sciencemakersSE/Turbiditetsmatare/koppling_bb.jpg

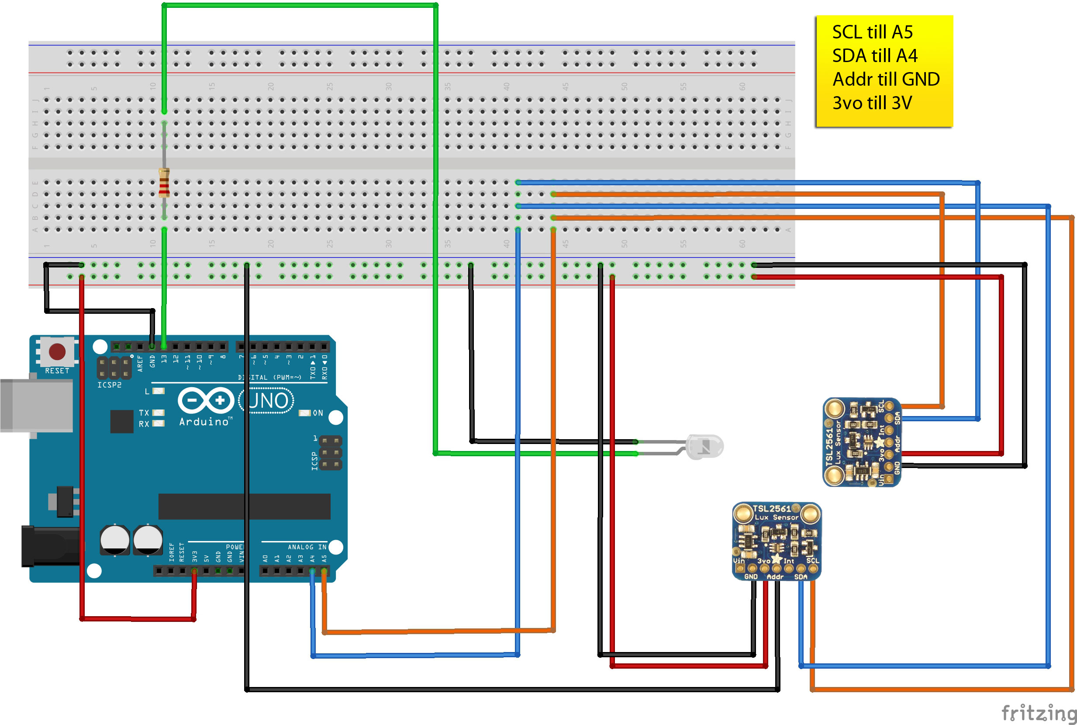
koppling_bb.jpg
