sciencemakersSE/Turbiditetsmatare/Turbidity_sensor_with_LCD.jpg

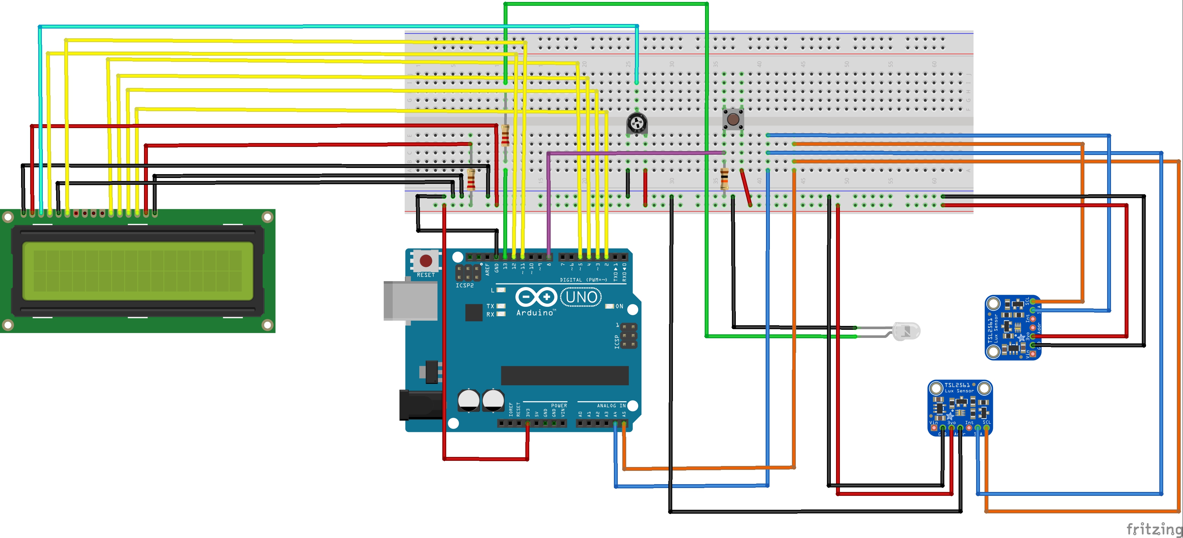
Turbidity_sensor_with_LCD.jpg
