sciencemakersSE/Turbiditetsmatare/README.md

# Turbiditetsmätare/ Turbidity meter
Här hittar man bygginstruktioner, kopplingsschema och Arduinokod till en turbiditetsmätare byggd i Lego.

Here are build instructions, wiring diagrams and Arduino code to a turbidity meter built in Lego
