sciencemakersSE/Turbiditetsmatare/Page_9_med_elektronik.png

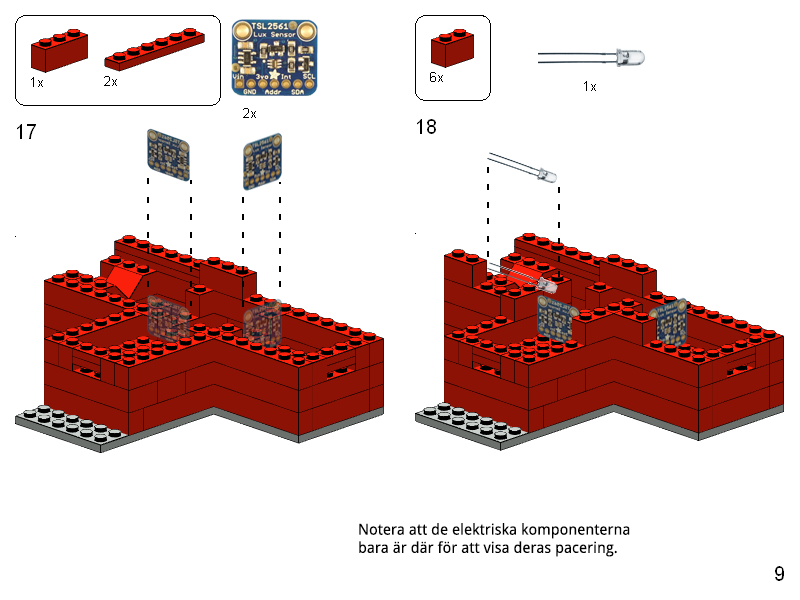
Page_9_med_elektronik.png
