sciencemakersSE/Turbiditetsmatare/Turbiditetsmatare.jpg

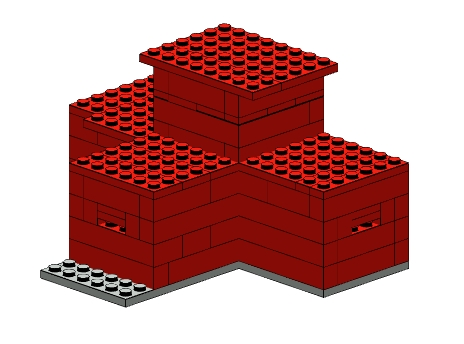
Turbiditetsmatare.jpg
